czupirrek/satnogs/docs-pics/2m_turnstile_single_el_pattern.jpg

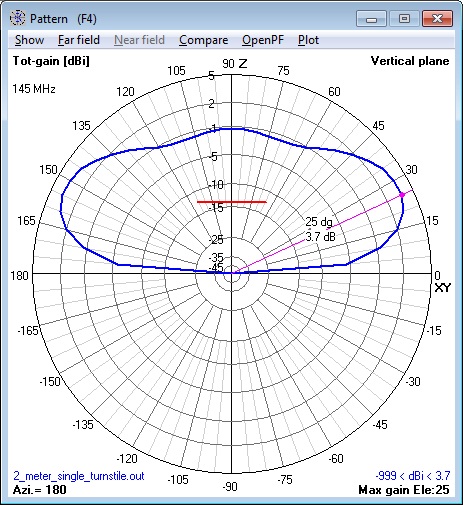
docs-pics/2m_turnstile_single_el_pattern.jpg
