czupirrek/satnogs/docs-pics/58sim.png

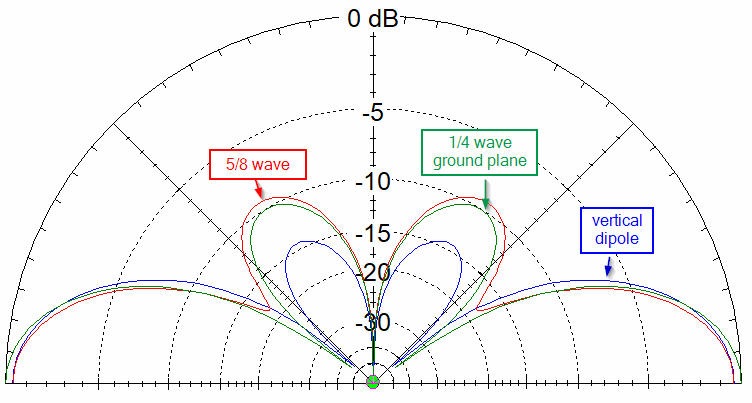
docs-pics/58sim.png
