czupirrek/satnogs/tracker/bom-rotator.xlsx

l.p. | produkt | opis | sztuk | cena netto szt. | cena netto sum | cena brutto szt. | cena brutto sum | link
1 | silnik krokowy | Nema 17 Bipolar 44Ncm | 2 | 56.1 | 112.2 |  |  | https://botland.com.pl/silniki-krokowe/3610-silnik-krokowy-jk42hs40-0504-200-krokowobr-12v05a043nm-5904422332013.html
2 | sterownik silnika krokowego | DRV8825 | 2 | 16.18 | 32.36 |  |  | https://botland.com.pl/sterowniki-silnikow-krokowych/3739-sterownik-silnika-krokowego-drv8825-stepstick-5904422332174.html
3 | profil alu 2020 | dług. 100mm | 18 | 2.91 | 52.38 |  |  | https://sklep.fleximo.pl/profil-aluminiowy-konstrukcyjny-20x20
4 | profil alu 2020 | dług. 140mm | 8 | 3.69 | 29.52 |  |  | https://sklep.fleximo.pl/profil-aluminiowy-konstrukcyjny-20x20
5 | nakrętka młoteczkowa 2020 |  | 36 | 1.53 | 55.08 |  |  | https://sklep.fleximo.pl/nakretka-mloteczkowa-6-M4
6 | kątownik 2020 | kątownik wewn. typ L | 40 | 7.93 | 317.2 |  |  | https://sklep.fleximo.pl/katownik-wpustowy-wewnetrzno-wewnetrzny-6
7 | łozysko | 625zz | 4 | 0.81 | 3.24 |  |  | https://poltech24.pl/625-zz-5x16x5-mm-lozysko-kulkowe-p-1353.html
8 | łożysko | 6008zz | 4 | 3.98 | 15.92 |  |  | https://poltech24.pl/6008-zz-40x68x15-mm-lozysko-kulkowe-p-1259.html
9 | Timing Belt GT2, Wide 6mm, Length 158mm, Teeth 79 | pasek GT2, szer. 6mm, fi5 | 2 |  |  | 4.42 | 8.84 | https://pl.aliexpress.com/item/32477498985.html
10 | Timing Pulley GT2 36T, bore 5mm, belt wide 6mm | koło pasowe GT2, 36T, szer. 6mm, fi5 | 2 |  |  | 3.8 | 7.6 | https://pl.aliexpress.com/item/32880112920.html
11 | ESP32 | mikrokontroler | 1 | 40.57 | 40.57 |  |  | https://botland.com.pl/moduly-wifi-i-bt-esp32/8893-esp32-wifi-bt-42-platforma-z-modulem-esp-wroom-32-zgodny-z-esp32-devkit-5904422337438.html
 |  |  |  | łącznie | 674.91
ew. kątowniki typu L (pozycja 6) mozna kupic o wiele taniej w innym sklepie. wtedy cena spadnie o 200zl
6 (alt) | kątownik 2020 | kątownik wewn. typ L | 40 |  |  | 2.61 | 104.4 | https://abc-rc.pl/pl/products/lacznik-katowy-l-type-do-profili-aluminiowych-2020-m4-tslot-t-nut-tnut-9748.html
jeszcze taniej można znaleźć je na aliexpress pod hasłem "hidden corner". cena wynosi ok. 1zł za sztukę. ciężko jednak ocenić ich jakość.
https://pl.aliexpress.com/item/1005007752218821.html?
