czupirrek/satnogs/tracker/stls/C1022-3-Main Axis Spacer.stl

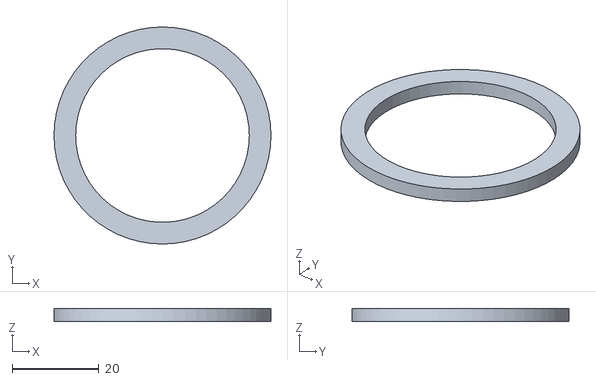
[picture p10: CAD file, 2025-06-03]
tracker/stls/C1022-3-Main Axis Spacer.stl
50.0 x 50.0 x 3.00
