czupirrek/satnogs/tracker/stls/C1010-3-Body.stl

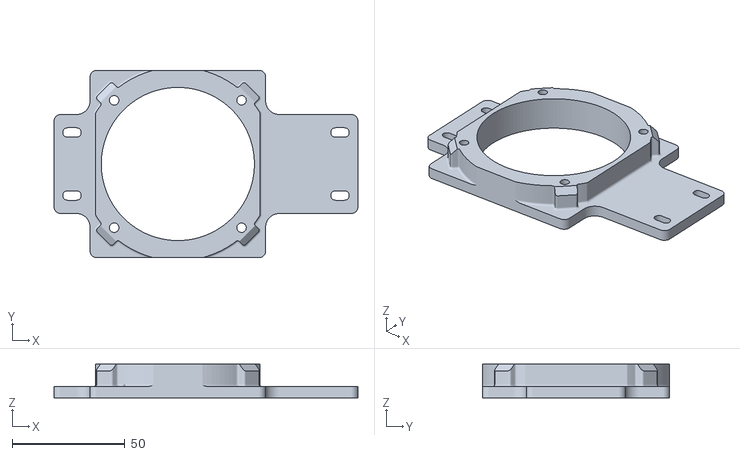
[picture p11: CAD file, 2025-06-03]
tracker/stls/C1010-3-Body.stl
135.0 x 83.2 x 15.0
