czupirrek/satnogs/tracker/stls/C1011-3-Body.stl

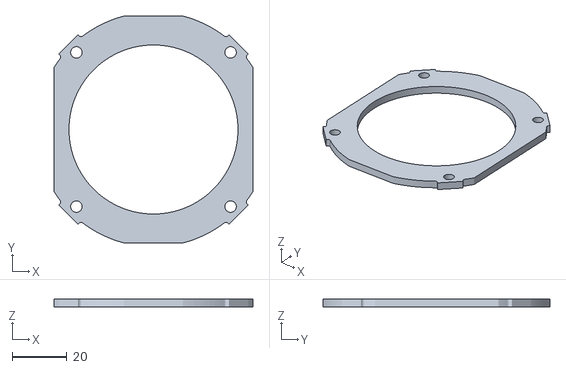
[picture p12: CAD file, 2025-06-03]
tracker/stls/C1011-3-Body.stl
73.0 x 83.2 x 3.00
