czupirrek/satnogs/tracker/stls/C1042-1_endstop_mount-Part.stl

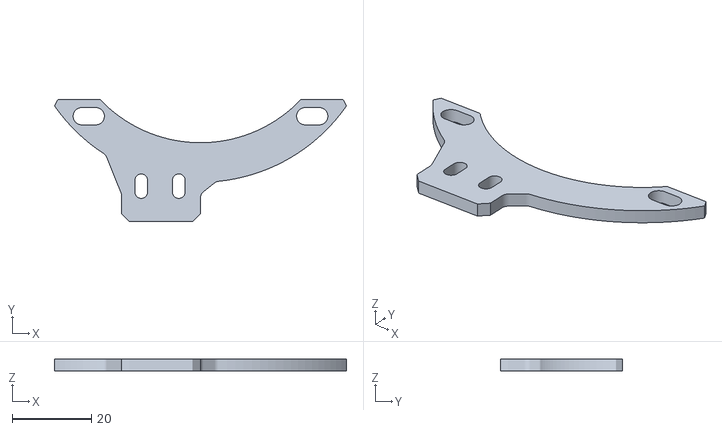
[picture p13: CAD file, 2025-06-03]
tracker/stls/C1042-1_endstop_mount-Part.stl
73.9 x 31.0 x 3.00
