czupirrek/satnogs/tracker/stls/C1061-5-Part.stl

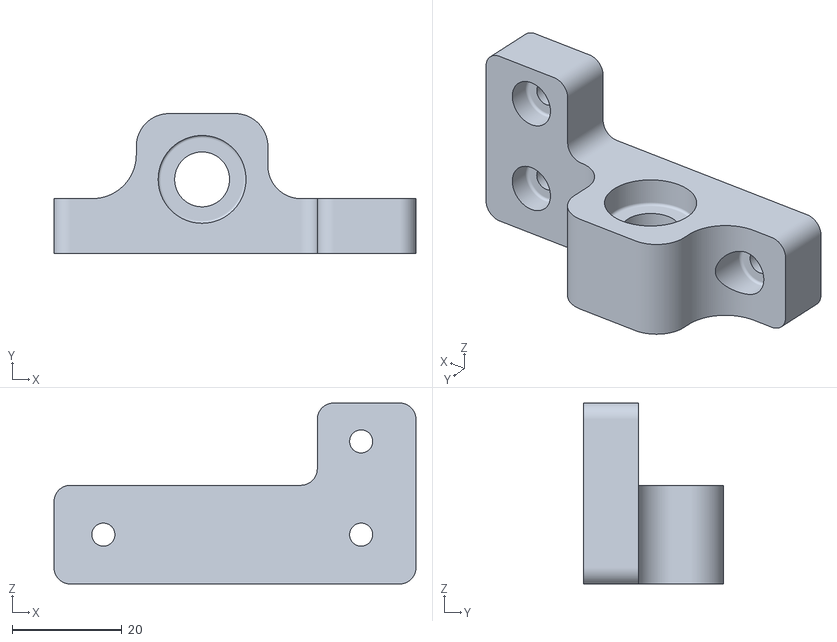
[picture p14: CAD file, 2025-06-03]
tracker/stls/C1061-5-Part.stl
66.0 x 25.5 x 33.0
