czupirrek/satnogs/tracker/stls/C1062-1_worm_gear-Pocket-M5nut.stl

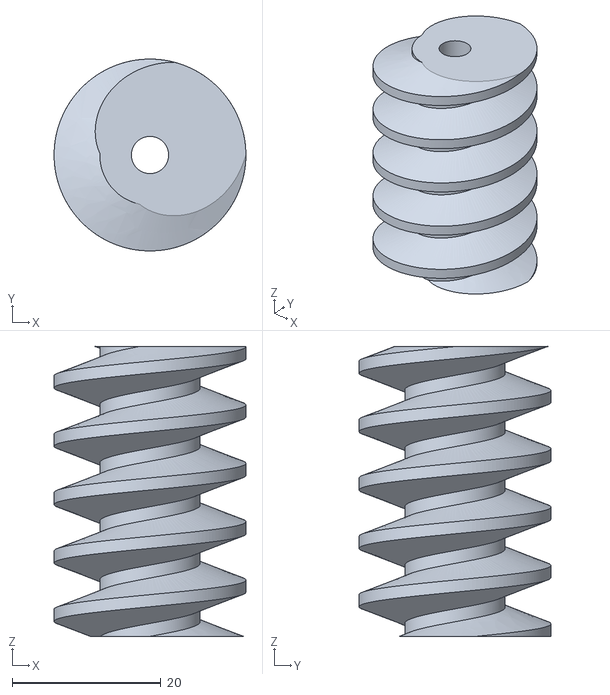
[picture p15: CAD file, 2025-06-03]
tracker/stls/C1062-1_worm_gear-Pocket-M5nut.stl
25.8 x 25.8 x 39.0
