czupirrek/satnogs/tracker/stls/C1021-1_shaft_collar-Fillet.stl

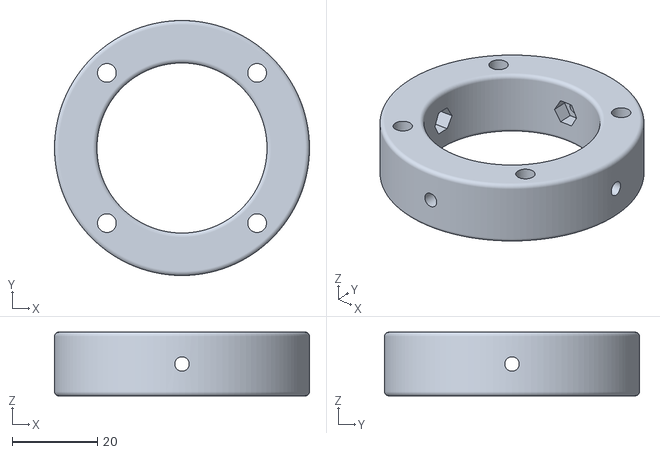
[picture p16: CAD file, 2025-06-03]
tracker/stls/C1021-1_shaft_collar-Fillet.stl
60.0 x 60.0 x 15.0
