czupirrek/satnogs/tracker/stls/C1020-1_shaft_gear-Part.stl

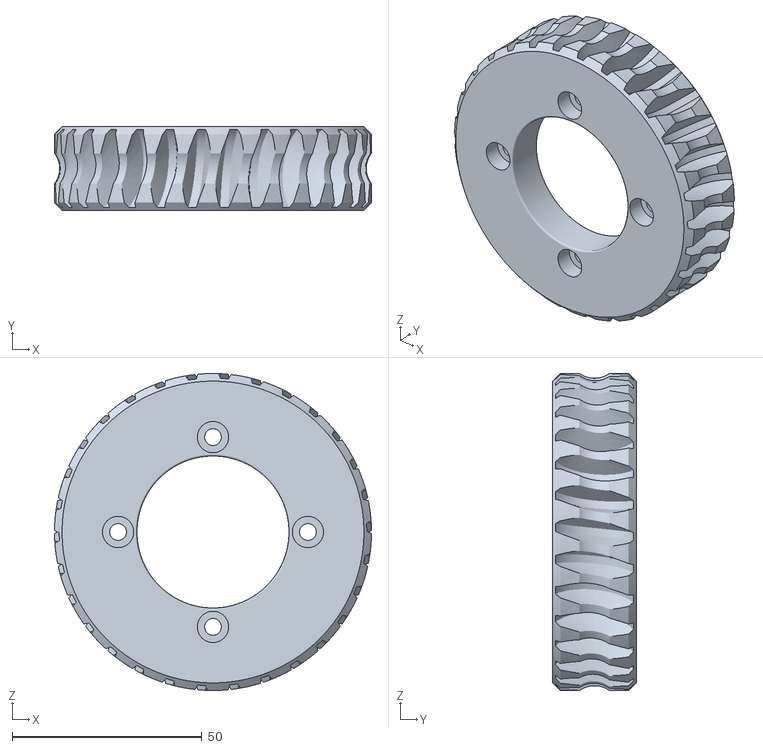
[picture p17: CAD file, 2025-06-03]
tracker/stls/C1020-1_shaft_gear-Part.stl
83.5 x 22.0 x 83.5
