czupirrek/satnogs/tracker/stls/C1040-1_encoder_gear-Chamfer001.stl

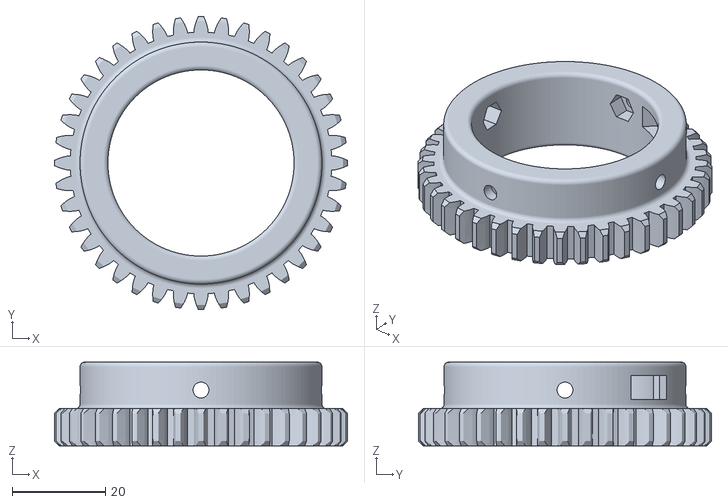
[picture p18: CAD file, 2025-06-03]
tracker/stls/C1040-1_encoder_gear-Chamfer001.stl
63.0 x 63.0 x 18.0
