czupirrek/satnogs/tracker/stls/C1030-1_motor_mount-Body.stl

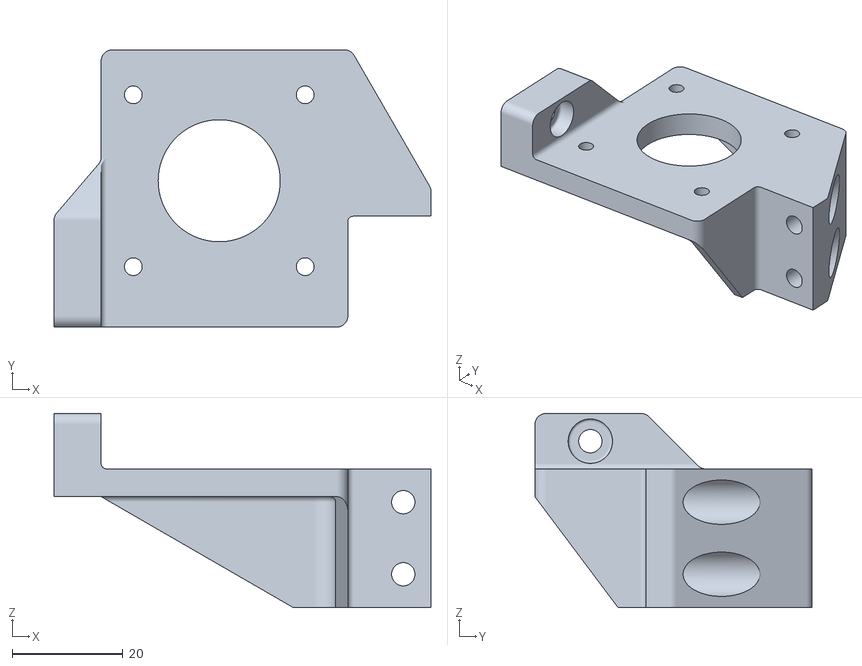
[picture p19: CAD file, 2025-06-03]
tracker/stls/C1030-1_motor_mount-Body.stl
68.0 x 50.0 x 35.0
