czupirrek/satnogs/tracker/stls/C1041-1_homing_pin-Fillet.stl

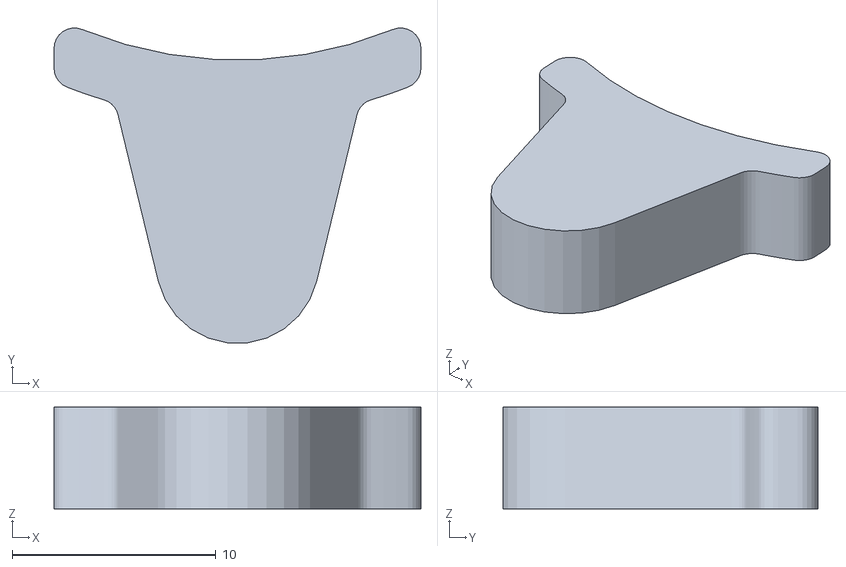
[picture p20: CAD file, 2025-06-03]
tracker/stls/C1041-1_homing_pin-Fillet.stl
18.0 x 15.4 x 5.00
