czupirrek/satnogs/tracker/stls/C1043-1_encoder_mount-Body.stl

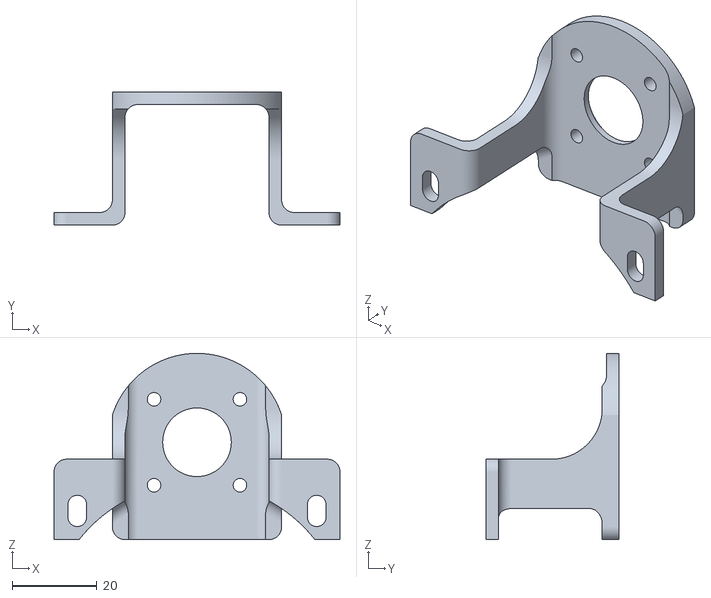
[picture p21: CAD file, 2025-06-03]
tracker/stls/C1043-1_encoder_mount-Body.stl
67.6 x 31.5 x 44.0
